WehningM/EspressoBoardA/Espressomaschine Board A/3dmodels/KF301-5.0-2P_LCSC_C474881.step

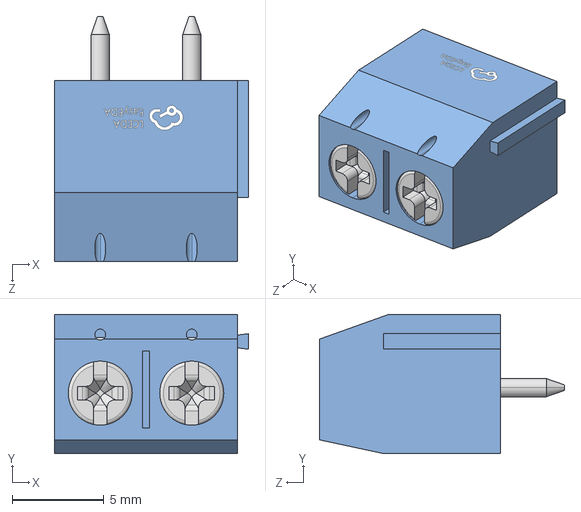
[picture p1: CAD file, 2026-10-08]
Espressomaschine Board A/3dmodels/KF301-5.0-2P_LCSC_C474881.step
10.6 x 7.60 x 13.4 mm
