WehningM/EspressoBoardA/Espressomaschine Board A/3dmodels/WAGO_2060-452_LCSC_C2765055.step

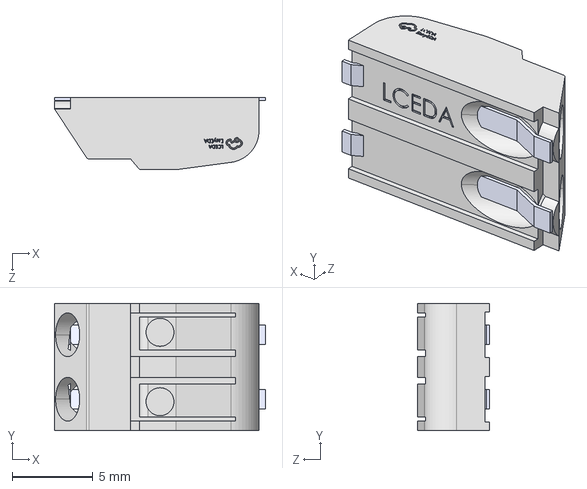
[picture p2: CAD file, 2026-10-08]
Espressomaschine Board A/3dmodels/WAGO_2060-452_LCSC_C2765055.step
13.1 x 7.90 x 4.50 mm
