WehningM/EspressoBoardA/Espressomaschine Board A/3dmodels/Relay_SPDT_Axicom_W11_V23101.step

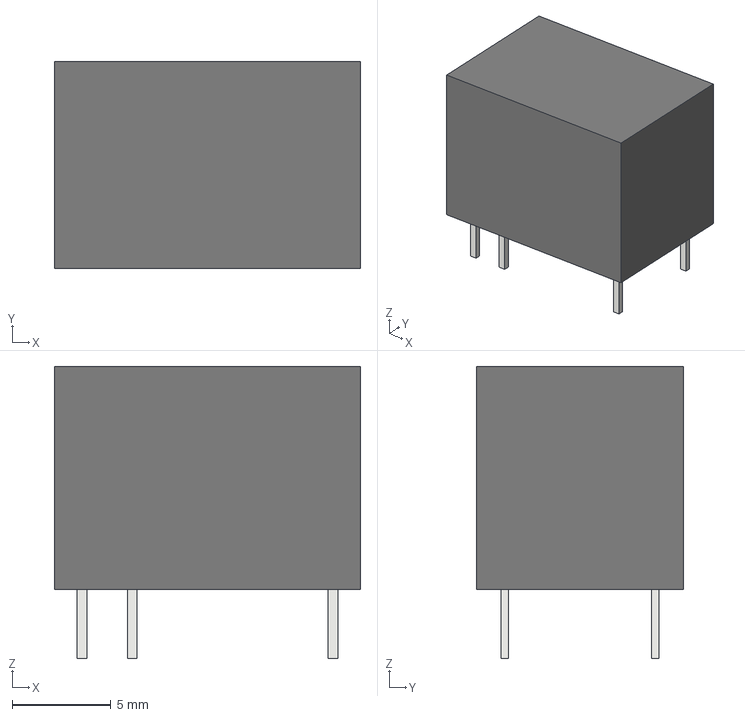
[picture p3: CAD file, 2026-10-08]
Espressomaschine Board A/3dmodels/Relay_SPDT_Axicom_W11_V23101.step
15.5 x 10.5 x 14.8 mm
