WehningM/EspressoBoardA/Espressomaschine Board A/3dmodels/MCP9600_QFN-20_5x5_LCSC_C220851.step

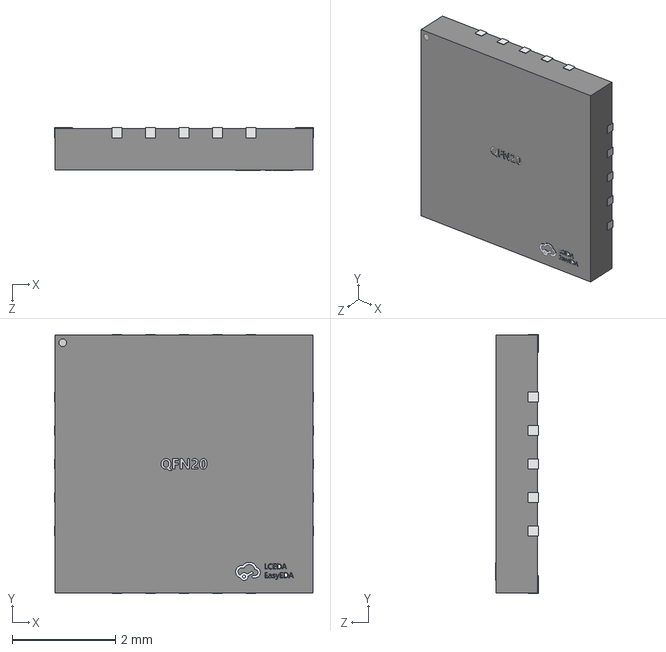
[picture p4: CAD file, 2026-10-08]
Espressomaschine Board A/3dmodels/MCP9600_QFN-20_5x5_LCSC_C220851.step
5.02 x 5.02 x 0.83 mm
