WehningM/EspressoBoardA/Espressomaschine Board A/3dmodels/JST_B4B-ZR_LCSC_C157997.step

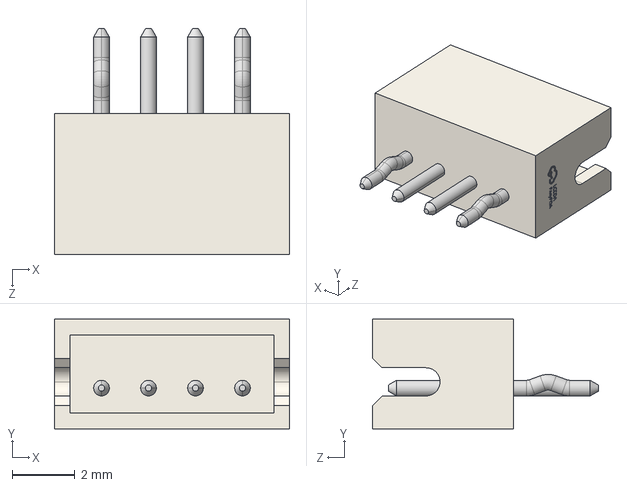
[picture p5: CAD file, 2026-10-08]
Espressomaschine Board A/3dmodels/JST_B4B-ZR_LCSC_C157997.step
7.50 x 3.50 x 7.20 mm
