WehningM/EspressoBoardA/Espressomaschine Board A/Espressomaschine Board A.kicad_pcb

## KiCad design Espressomaschine Board A/Espressomaschine Board A.kicad_pcb (2026-10-08)

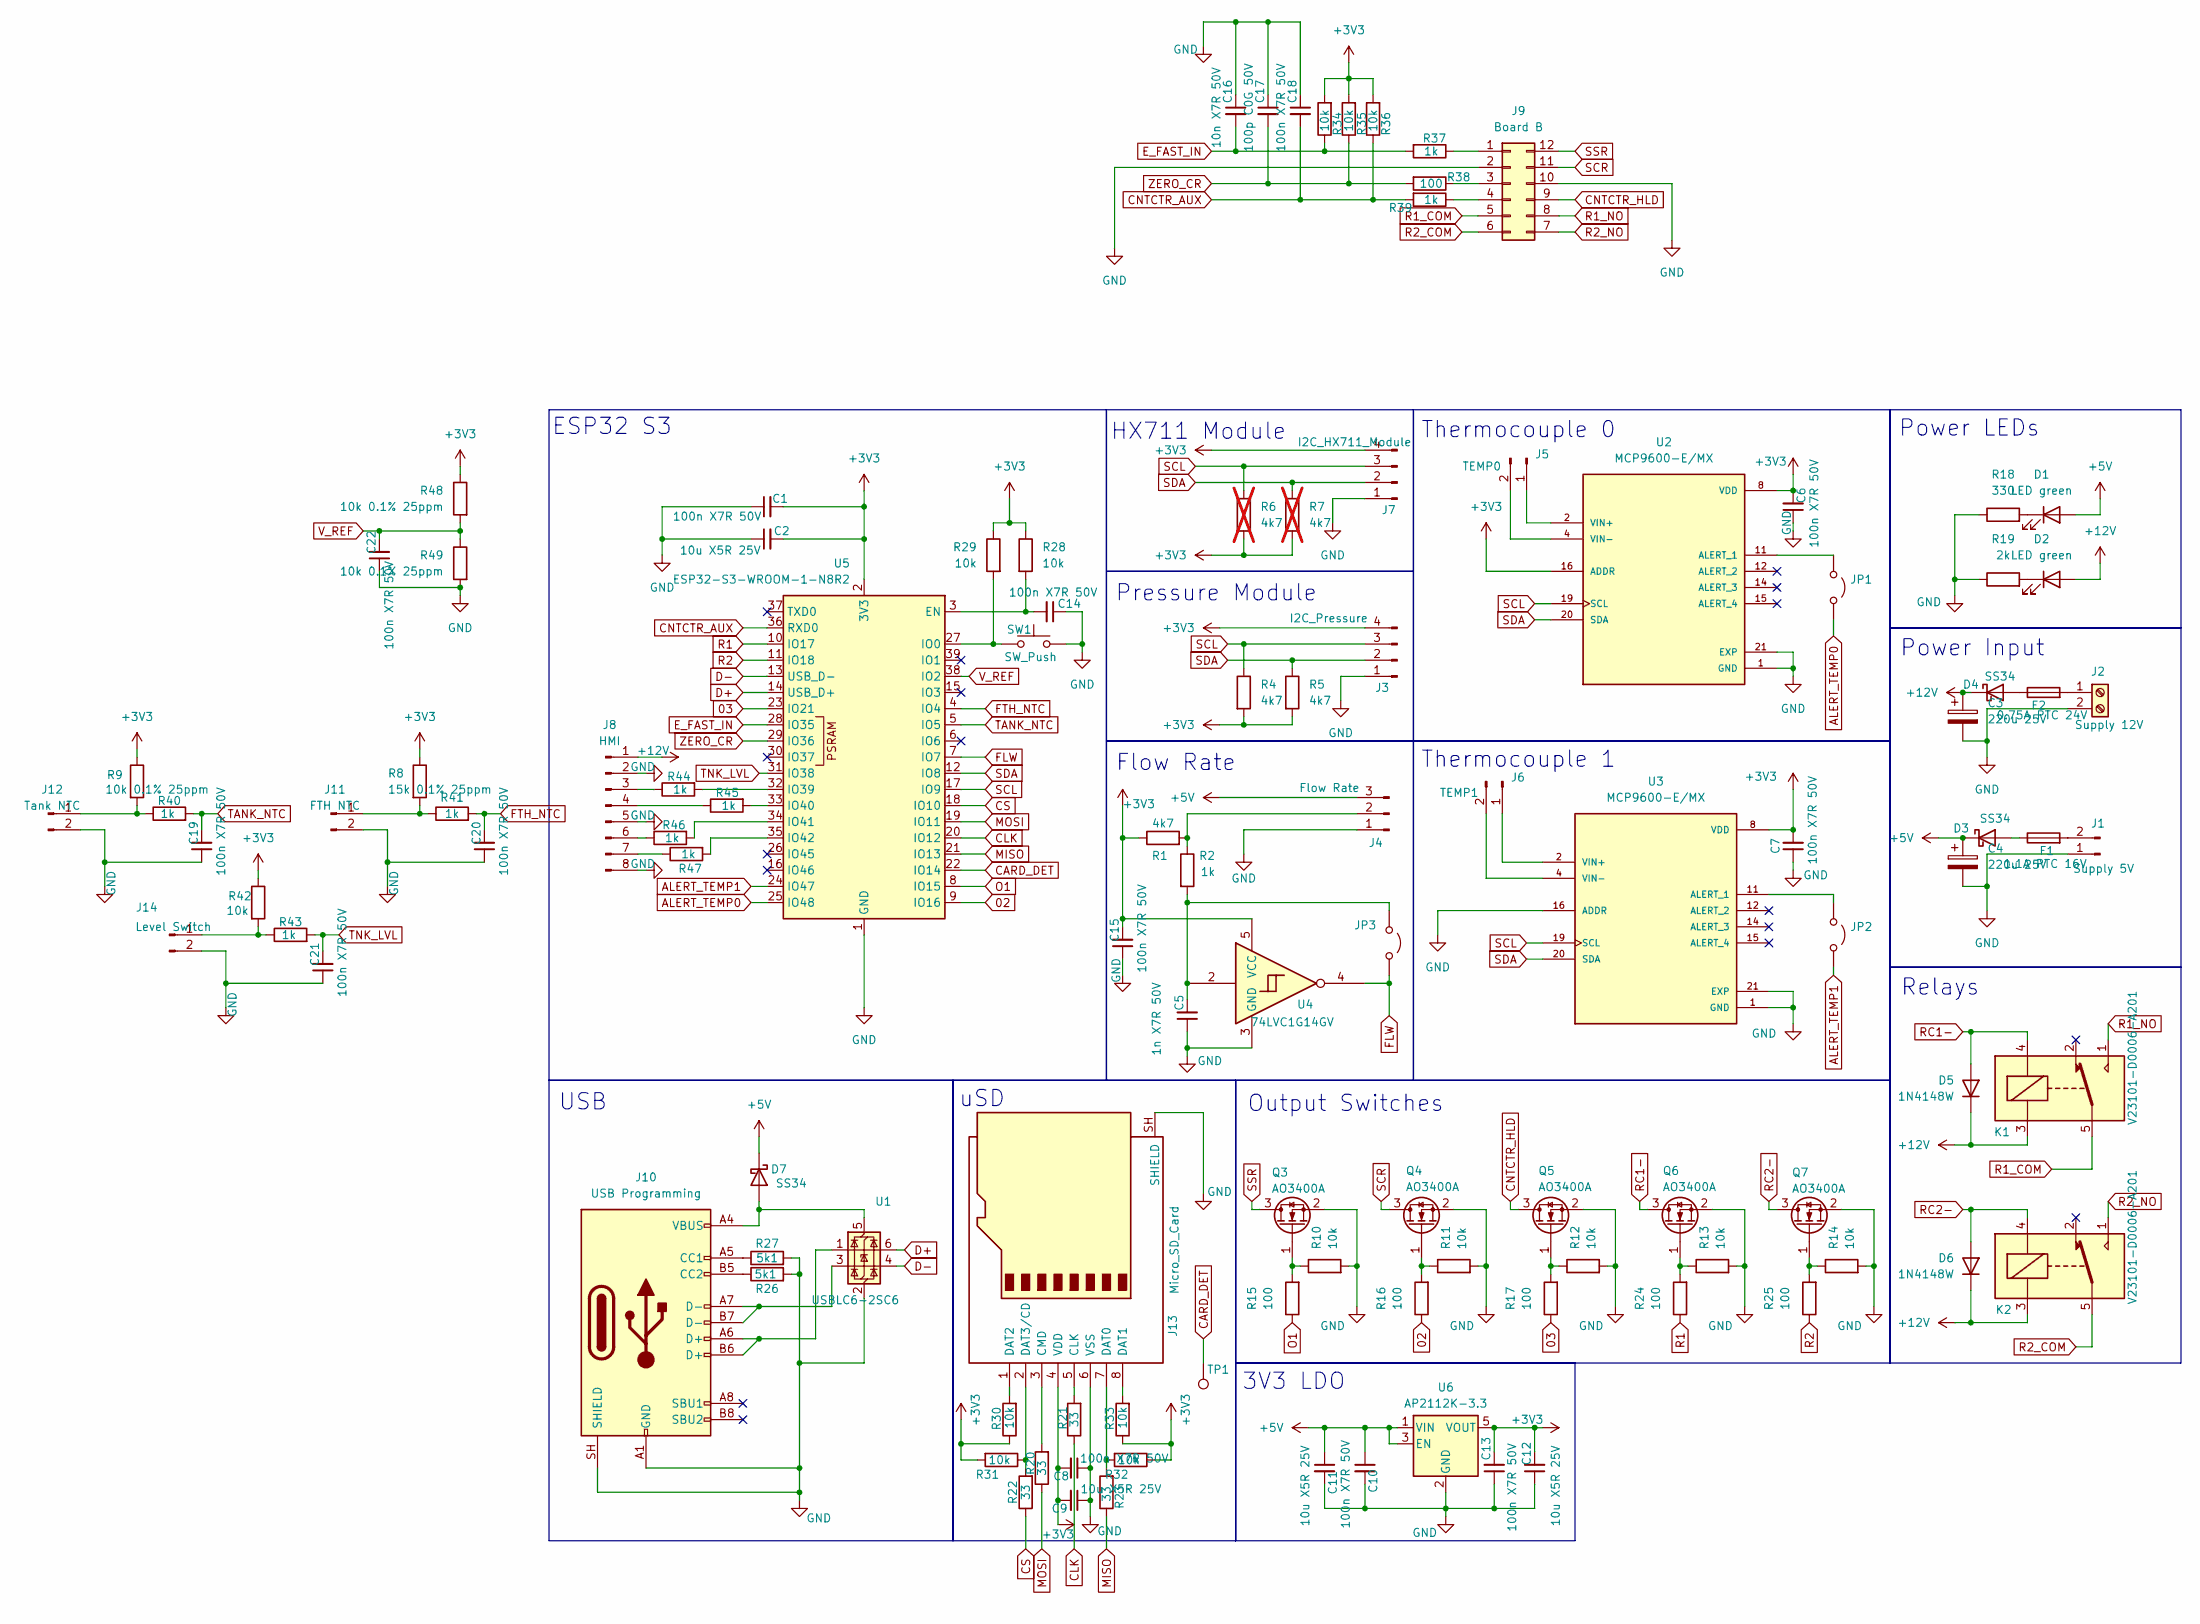
[picture p6: schematic Espressomaschine Board A.kicad_sch]

Parts:
C1, C6, C7, C8, C10, C13, C14, C15, C18, C19, C20, C21, C22: 100n X7R 50V; C_0603_1608Metric; MPN CC0603KRX7R9BB104; LCSC C14663
C2, C9, C11, C12: 10u X5R 25V; C_0805_2012Metric_Pad1.18x1.45mm_HandSolder; MPN CL21A106KAYNNNE; LCSC C15850
C3, C4: 220u 25V; CP_Radial_D10.0mm_P3.50mm; MPN 25YXF220MEFC8X11.5
C5: 1n X7R 50V; C_0603_1608Metric; MPN CL10B102KB8NNNC; LCSC C1588
C16: 10n X7R 50V; C_0603_1608Metric; MPN 0603B103K500NT; LCSC C57112
C17: 100p C0G 50V; C_0603_1608Metric; MPN CL10C101JB8NNNC; LCSC C14858
D1, D2: LED green; LED_0805_2012Metric_Pad1.15x1.40mm_HandSolder; MPN KT-0805G; LCSC C2297
D3, D4, D7: SS34; D_SMA_Handsoldering; MPN SS34; LCSC C8678
D5, D6: 1N4148W; D_SOD-123; MPN 1N4148W; LCSC C81598
F1: 1.1A PTC 16V; Fuse_1812_4532Metric; MPN SMD1812P110TF/16
F2: 0.75A PTC 24V; Fuse_1812_4532Metric; MPN SMD1812P075TF/24
J1: Supply 5V; JST_XH_S2B-XH-A-1_1x02_P2.50mm_Horizontal; MPN S2B-XH-A-1(LF)(SN)
J2: Supply 12V; TerminalBlock_MetzConnect_Type011_RT05502HBLC_1x02_P5.00mm_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; MPN KF301-5.0-2P
J3: I2C_Pressure; JST_ZH_B4B-ZR_1x04_P1.50mm_Vertical; MPN B4B-ZR(LF)(SN)
J4: Flow Rate; JST_XH_S3B-XH-A-1_1x03_P2.50mm_Horizontal; MPN S3B-XH-A-1(LF)(SN)
J5: TEMP0; WAGO2060; MPN 2060-452/998-404
J6: TEMP1; WAGO2060; MPN 2060-452/998-404
J7: I2C_HX711_Module; JST_PH_S4B-PH-K_1x04_P2.00mm_Horizontal; MPN S4B-PH-K-S(LF)(SN)
J8: HMI; TE_84952-8_1x08-1MP_P1.0mm_Horizontal; MPN 84952-8
J9: Board B; IDC-Header_2x06_P2.54mm_Horizontal; MPN 2.54-2*6P
J10: USB Programming; USB_C_Receptacle_GCT_USB4105-xx-A_16P_TopMnt_Horizontal; MPN USB4105-GF-A-120
J11: FTH NTC; JST_XH_B2B-XH-A_1x02_P2.50mm_Vertical; MPN B2B-XH-A(LF)(SN)
J12: Tank NTC; JST_XH_B2B-XH-A_1x02_P2.50mm_Vertical; MPN B2B-XH-A(LF)(SN)
J13: Micro_SD_Card; microSD_HC_Hirose_DM3D-SF; MPN DM3D-SF
J14: Level Switch; JST_XH_B2B-XH-A_1x02_P2.50mm_Vertical; MPN B2B-XH-A(LF)(SN)
JP1, JP2, JP3: Jumper_2_Open; SolderJumper-2_P1.3mm_Open_RoundedPad1.0x1.5mm
K1, K2: V23101-D0006-A201; Relay_SPDT_Axicom_W11_V23101-D0xxx-A; MPN V23101-D0006-A201
Q3, Q4, Q5, Q6, Q7: AO3400A; SOT-23; MPN AO3400A; LCSC C20917
R1, R4, R5: 4k7; R_0805_2012Metric_Pad1.20x1.40mm_HandSolder; MPN 0805W8F4701T5E; LCSC C17673
R2, R37, R39, R40, R41, R43, R44, R45, R46, R47: 1k; R_0805_2012Metric_Pad1.20x1.40mm_HandSolder; MPN 0805W8F1001T5E; LCSC C17513
R6, R7: 4k7; R_0805_2012Metric_Pad1.20x1.40mm_HandSolder; MPN 0805W8F4701T5E; not fitted
R8: 15k 0.1% 25ppm; R_0805_2012Metric_Pad1.20x1.40mm_HandSolder; MPN RT0805BRD0715KL
R9, R48, R49: 10k 0.1% 25ppm; R_0805_2012Metric_Pad1.20x1.40mm_HandSolder; MPN RT0805BRD0710KL
R10, R11, R12, R13, R14, R28, R29, R30, R31, R32, R33, R34, R35, R36, R42: 10k; R_0805_2012Metric_Pad1.20x1.40mm_HandSolder; MPN 0805W8F1002T5E; LCSC C17414
R15, R16, R17, R24, R25, R38: 100; R_0805_2012Metric_Pad1.20x1.40mm_HandSolder; MPN 0805W8F1000T5E; LCSC C17408
R18: 330; R_0805_2012Metric_Pad1.20x1.40mm_HandSolder; MPN 0805W8F3300T5E; LCSC C17630
R19: 2k; R_0805_2012Metric_Pad1.20x1.40mm_HandSolder; MPN 0805W8F2001T5E; LCSC C17604
R20, R21, R22, R23: 33; R_0805_2012Metric_Pad1.20x1.40mm_HandSolder; MPN 0805W8F330JT5E; LCSC C17634
R26, R27: 5k1; R_0805_2012Metric_Pad1.20x1.40mm_HandSolder; MPN 0805W8F5101T5E; LCSC C27834
SW1: SW_Push; SW_SPST_EVQP2_MiddlePushTravel_H2.5mm; MPN EVQP2P02W
TP1: TestPoint; TestPoint_Pad_D2.0mm
U1: USBLC6-2SC6; SOT-23-6; MPN USBLC6-2SC6
U2, U3: MCP9600-E/MX; QFN65P500X500X100-21N; PARTREV F
U4: 74LVC1G14GV; SOT-23-5_HandSoldering; MPN 74LVC1G14GV,125
U5: ESP32-S3-WROOM-1-N8R2; ESP32-S3-WROOM-1; MPN ESP32-S3-WROOM-1-N8R2
U6: AP2112K-3.3; SOT-23-5; MPN AP2112K-3.3TRG1

Connections:
02: R16.1, U5.9 (IO16)
03: R17.1, U5.23 (IO21)
+3V3: C1.2, C2.2, C6.2, C7.2, C8.2, C9.2, C12.2, C13.2, C15.2, J3.4, J7.4, J13.4 (VDD), R1.1, R4.2, R5.2, R6.2, R7.2, R8.1, R9.1, R28.1, R29.1, R30.1, R31.2, R32.1, R33.1, R34.2, R35.2, R36.2, R42.1, R48.1, U2.8 (VDD), U2.16 (ADDR), U3.8 (VDD), U4.5 (VCC), U5.2 (3V3), U6.5 (VOUT)
+5V: C4.1, C10.1, C11.1, D1.2 (A), D3.1 (K), D7.1 (K), J4.3, U6.1 (VIN), U6.3 (EN)
+12V: C3.1, D2.2 (A), D4.1 (K), D5.1 (K), D6.1 (K), J8.1, K1.3, K2.3
ALERT_TEMP0: JP1.2 (B), U5.25 (IO48)
ALERT_TEMP1: JP2.2 (B), U5.24 (IO47)
CARD_DET: TP1.1 (1_1), U5.22 (IO14)
CLK: R21.1, U5.20 (IO12)
CNTCTR_AUX: C18.2, R36.1, R39.2, U5.36 (RXD0)
CNTCTR_HLD: J9.9, Q5.3 (D)
CS: R22.1, U5.18 (IO10)
D+: U1.6 (I/O1), U5.14 (USB_D+)
D-: U1.4 (I/O2), U5.13 (USB_D-)
E_FAST_IN: C16.2, R34.1, R37.2, U5.28 (IO35)
FLW: JP3.2 (B), U4.4, U5.7 (IO7)
FTH_NTC: C20.2, R41.2, U5.4 (IO4)
GND: C1.1, C2.1, C3.2, C4.2, C5.1, C6.1, C7.1, C8.1, C9.1, C10.2, C11.2, C12.1, C13.1, C14.1, C15.1, C16.1, C17.1, C18.1, C19.1, C20.1, C21.1, C22.1, J1.1, J2.2, J3.1, J4.1, J7.1, J8.2, J8.5, J8.8, J9.2, J9.10, J10.A1 (GND), J10.A12 (GND), J10.B1 (GND), J10.B12 (GND), J10.SH (SHIELD), J11.2, J12.2, J13.6 (VSS), J13.SH (SHIELD), J14.2, Q3.2 (S), Q4.2 (S), Q5.2 (S), Q6.2 (S), Q7.2 (S), R10.2, R11.2, R12.2, R13.2, R14.2, R18.1, R19.1, R26.2, R27.2, R49.2, SW1.2, U1.2 (GND), U2.1 (GND), U2.3 (GND), U2.5 (GND), U2.6 (GND), U2.7 (GND), U2.9 (GND), U2.10 (GND), U2.13 (GND), U2.17 (GND), U2.18 (GND), U2.21 (EXP), U2.22 (EXP), U2.23 (EXP), U2.24 (EXP), U2.25 (EXP), U2.26 (EXP), U2.27 (EXP), U2.28 (EXP), U2.29 (EXP), U2.30 (EXP), U3.1 (GND), U3.3 (GND), U3.5 (GND), U3.6 (GND), U3.7 (GND), U3.9 (GND), U3.10 (GND), U3.13 (GND), U3.16 (ADDR), U3.17 (GND), U3.18 (GND), U3.21 (EXP), U3.22 (EXP), U3.23 (EXP), U3.24 (EXP), U3.25 (EXP), U3.26 (EXP), U3.27 (EXP), U3.28 (EXP), U3.29 (EXP), U3.30 (EXP), U4.3 (GND), U5.1 (GND), U5.40 (GND), U5.41 (GND), U6.2 (GND)
MISO: R23.1, U5.21 (IO13)
MOSI: R20.1, U5.19 (IO11)
unnamed: D1.1 (K), R18.2
unnamed: D2.1 (K), R19.2
unnamed: D3.2 (A), F1.1
unnamed: D4.2 (A), F2.1
unnamed: D7.2 (A), J10.A4 (VBUS), J10.A9 (VBUS), J10.B4 (VBUS), J10.B9 (VBUS), U1.5 (VBUS)
unnamed: F1.2, J1.2
unnamed: F2.2, J2.1
unnamed: J4.2, R1.2, R2.1
unnamed: J5.1, U2.2 (VIN+)
unnamed: J5.2, U2.4 (VIN-)
unnamed: J6.1, U3.2 (VIN+)
unnamed: J6.2, U3.4 (VIN-)
unnamed: J8.3, R44.1
unnamed: J8.4, R45.1
unnamed: J8.6, R46.1
unnamed: J8.7, R47.1
unnamed: J9.1, R37.1
unnamed: J9.3, R38.1
unnamed: J9.4, R39.1
unnamed: J10.A5 (CC1), R27.1
unnamed: J10.B5 (CC2), R26.1
unnamed: J10.A6 (D+), J10.B6 (D+), U1.1 (I/O1)
unnamed: J10.A7 (D-), J10.B7 (D-), U1.3 (I/O2)
unnamed: J11.1, R8.2, R41.1
unnamed: J12.1, R9.2, R40.1
unnamed: J13.5 (CLK), R21.2
unnamed: J13.3 (CMD), R20.2
unnamed: J13.7 (DAT0), R23.2, R32.2
unnamed: J13.8 (DAT1), R33.2
unnamed: J13.1 (DAT2), R30.2
unnamed: J13.2 (DAT3/CD), R22.2, R31.1
unnamed: J14.1, R42.2, R43.1
unnamed: JP1.1 (A), U2.11 (ALERT_1)
unnamed: JP2.1 (A), U3.11 (ALERT_1)
unnamed: C5.2, JP3.1 (A), R2.2, U4.2
unnamed: Q3.1 (G), R10.1, R15.2
unnamed: Q4.1 (G), R11.1, R16.2
unnamed: Q5.1 (G), R12.1, R17.2
unnamed: Q6.1 (G), R13.1, R24.2
unnamed: Q7.1 (G), R14.1, R25.2
unnamed: C14.2, R28.2, U5.3 (EN)
unnamed: R29.2, SW1.1, U5.27 (IO0)
unnamed: R44.2, U5.32 (IO39)
unnamed: R45.2, U5.33 (IO40)
unnamed: R46.2, U5.34 (IO41)
unnamed: R47.2, U5.35 (IO42)
O1: R15.1, U5.8 (IO15)
R1: R24.1, U5.10 (IO17)
R1_COM: J9.5, K1.5, K1.6
R1_NO: J9.8, K1.1
R2: R25.1, U5.11 (IO18)
R2_COM: J9.6, K2.5, K2.6
R2_NO: J9.7, K2.1
RC1-: D5.2 (A), K1.4, Q6.3 (D)
RC2-: D6.2 (A), K2.4, Q7.3 (D)
SCL: J3.3, J7.3, R4.1, R6.1, U2.19 (SCL), U3.19 (SCL), U5.17 (IO9)
SCR: J9.11, Q4.3 (D)
SDA: J3.2, J7.2, R5.1, R7.1, U2.20 (SDA), U3.20 (SDA), U5.12 (IO8)
SSR: J9.12, Q3.3 (D)
TANK_NTC: C19.2, R40.2, U5.5 (IO5)
TNK_LVL: C21.2, R43.2, U5.31 (IO38)
V_REF: C22.2, R48.2, R49.1, U5.38 (IO2)
ZERO_CR: C17.2, R35.1, R38.2, U5.29 (IO36)

Notes on the sheet:
ESP32 S3
Power LEDs
USB
Thermocouple 0
HX711 Module
Output Switches
3V3 LDO
uSD
Power Input
Flow Rate
Thermocouple 1
Pressure Module
Relays

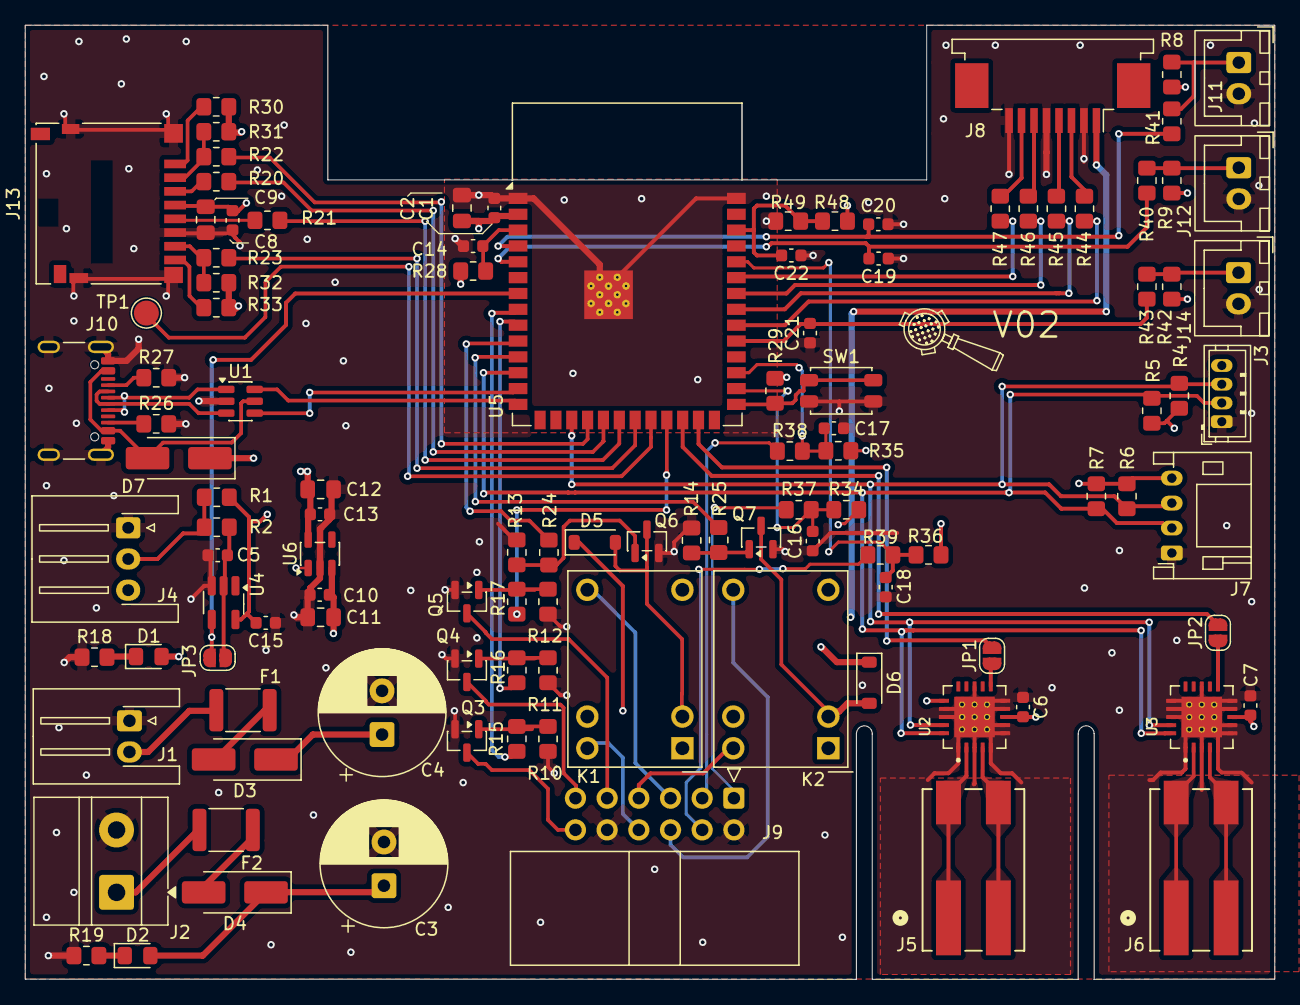
[picture p7: board Espressomaschine Board A.kicad_pcb from above]

Board: 4 copper layers, 100.2 x 76.5 mm, 111 parts (0 on the bottom side), 83 nets.
